Matt266/Crude-Class-D-Audio-Amplifier/spice_files/class_d_amp_final_design.asc

C1: cap; 100nF
C2: cap; 100nF
C3: polcap; 100µF
C5: cap; 10nF
C6: cap; 100nF
C7: cap; 1nF
C8: polcap; 100µF
D1: schottky; B550C
D2: schottky; B550C
D3: schottky; B550C
D4: schottky; B550C
D5: schottky; B550C
D6: schottky; B550C
D7: schottky; B550C
D8: schottky; B550C
D9: schottky; B550C
D10: schottky; B550C
M1: nmos; PSMN057200B
M2: nmos; PSMN057200B
M3: nmos; PSMN057200B
M4: nmos; PSMN057200B
Q1: npn; BD139
Q2: npn; BD139
Q3: npn; BD139
Q4: npn; BD139
Q5: npn; BC547C
Q6: npn; BC547C
Q7: pnp; BC557C
Q8: pnp; BC557C
Q9: npn; BC547C
Q10: npn; BC547C
R1: res; 1k
R2: res; 10
R3: res; 1k
R4: res; 1k
R5: res; 10
R6: res; 1k
R7: res; 10
R8: res; 10
R9: res; 10
R10: res; 10
R11: res; 1000
R12: res; 1000
R13: res; 50
R14: res; 50
R15: res; 10k
R16: res; 10k
R17: res; 4
R18: res; 220
R19: res; 220
R20: res; 3k
R21: res; 22
R22: res; 22
R23: res; 1.47Mega
R24: res; 100k
U1: LM393A
U2: LM393A
U3: NE555
V1: voltage; 12
V3: voltage; 5
V4: signal; SINE(0 1.75 2k 0 0 0); Rser=600
Named nets: 0, Vref, audio_in, 5V, Vcc
200kHz
.tran 0 25ms 1ms
